mit41301/RDA5807M-arduino-nano-clone-FM-radio/mega328_FM/mega328_FM-B.Cu-single.pdf

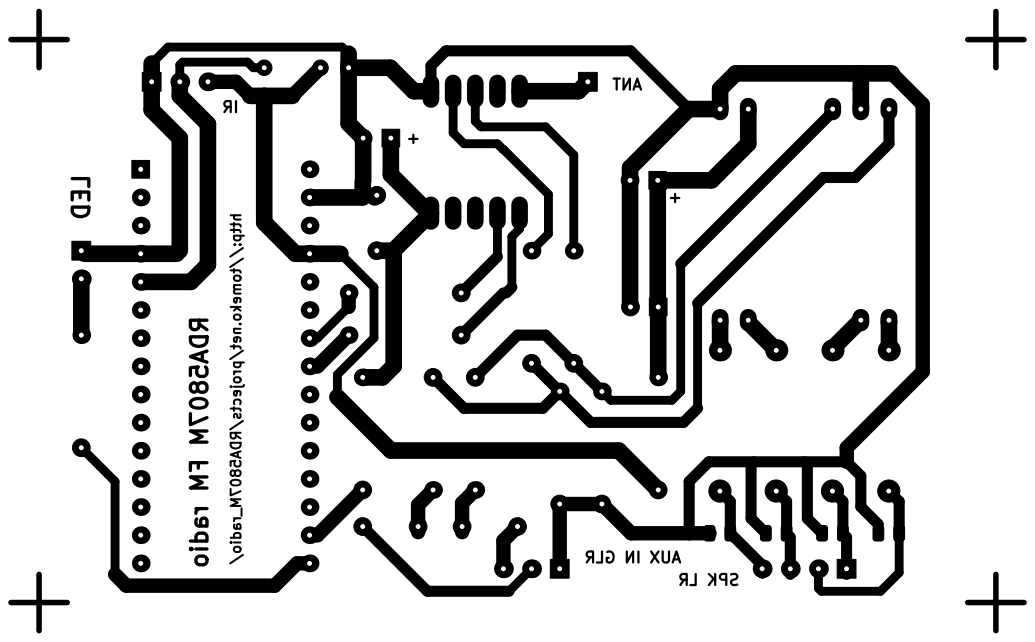
[picture p1: page 1]

AUX IN GLR LED http://tomeko.net/projects/RDA5807M_radio/ RDA5807M FM radio
