mit41301/RDA5807M-arduino-nano-clone-FM-radio/mega328_FM/mega328_FM-B.Cu.pdf

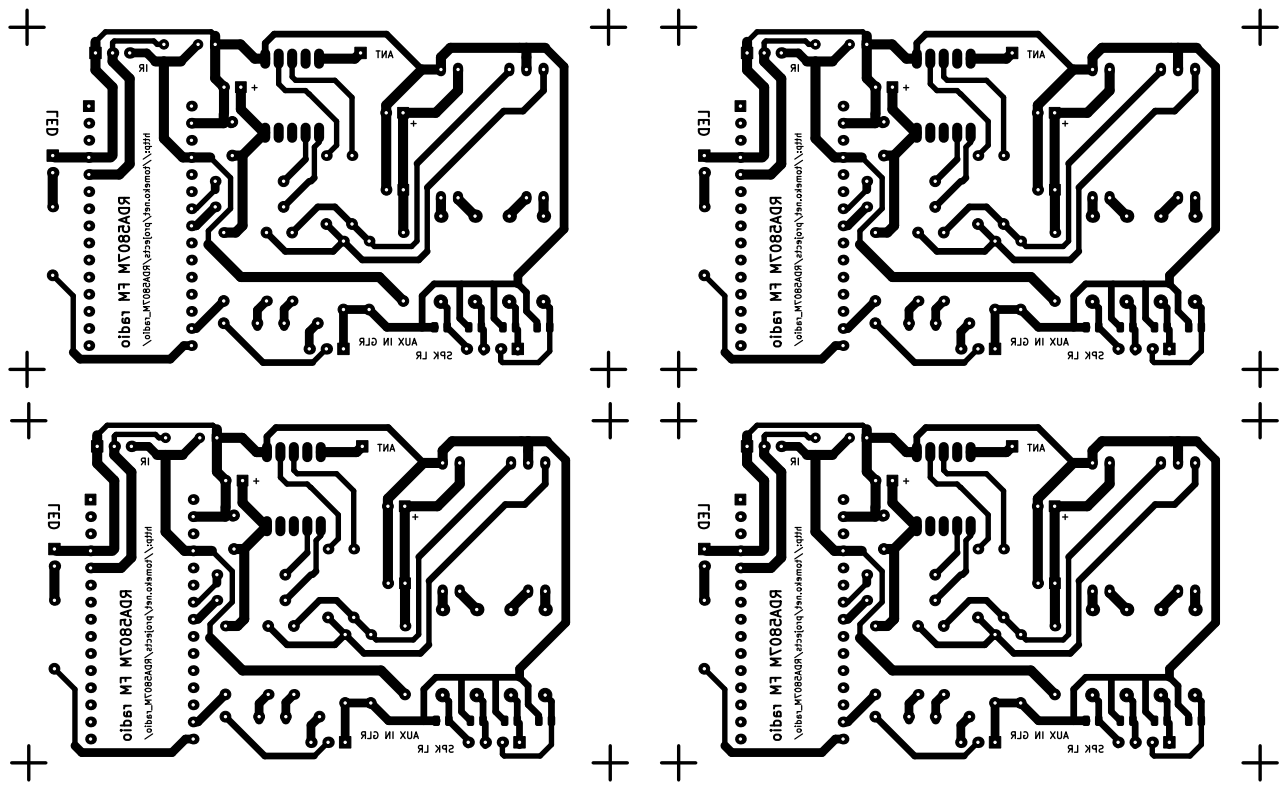
[picture p2: page 1]

AUX IN GLR LED http://tomeko.net/projects/RDA5807M_radio/ RDA5807M FM radio

SPK LR http://tomeko.net/projects/RDA5807M_radio/ RDA5807M FM radio

SPK LR + AUX IN GLR

AUX IN GLR LED RDA5807M FM radio + http://tomeko.net/projects/RDA5807M_radio/ + LED http://tomeko.net/projects/RDA5807M_radio/ ANT AUX IN GLR

IR + ANT SPK LR
