mit41301/RDA5807M-arduino-nano-clone-FM-radio/mega328_FM/mega328_FM.pdf

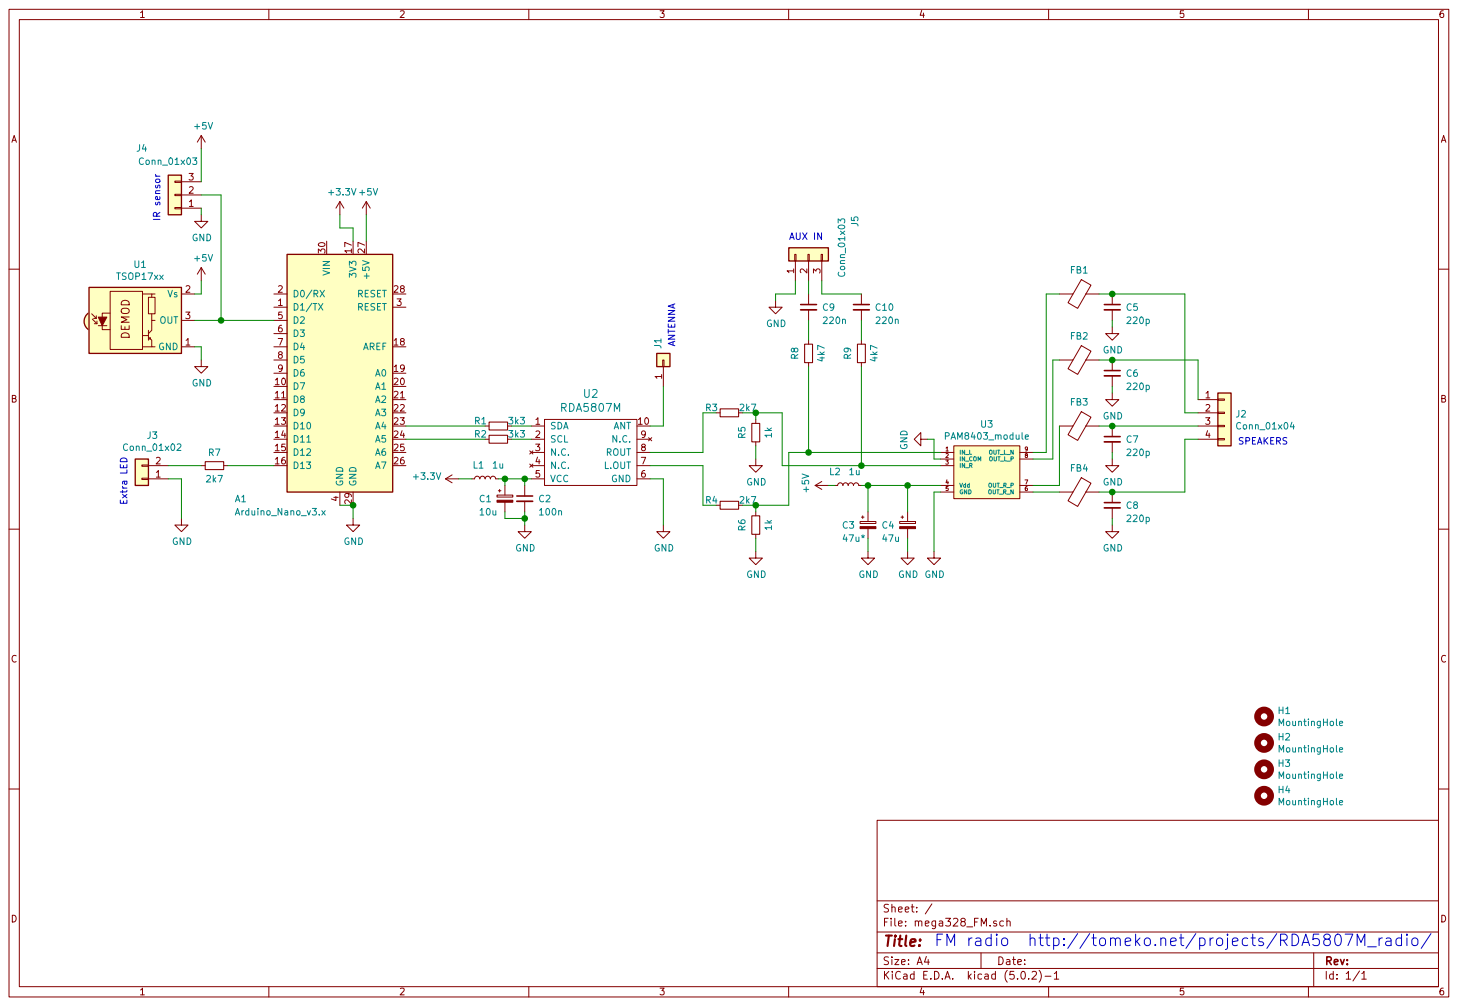
[picture p3: page 1]
