mit41301/RDA5807M-arduino-nano-clone-FM-radio/mega328_FM/mega328_FM.kicad_pcb

## KiCad design mega328_FM/mega328_FM.kicad_pcb (2025-11-18)

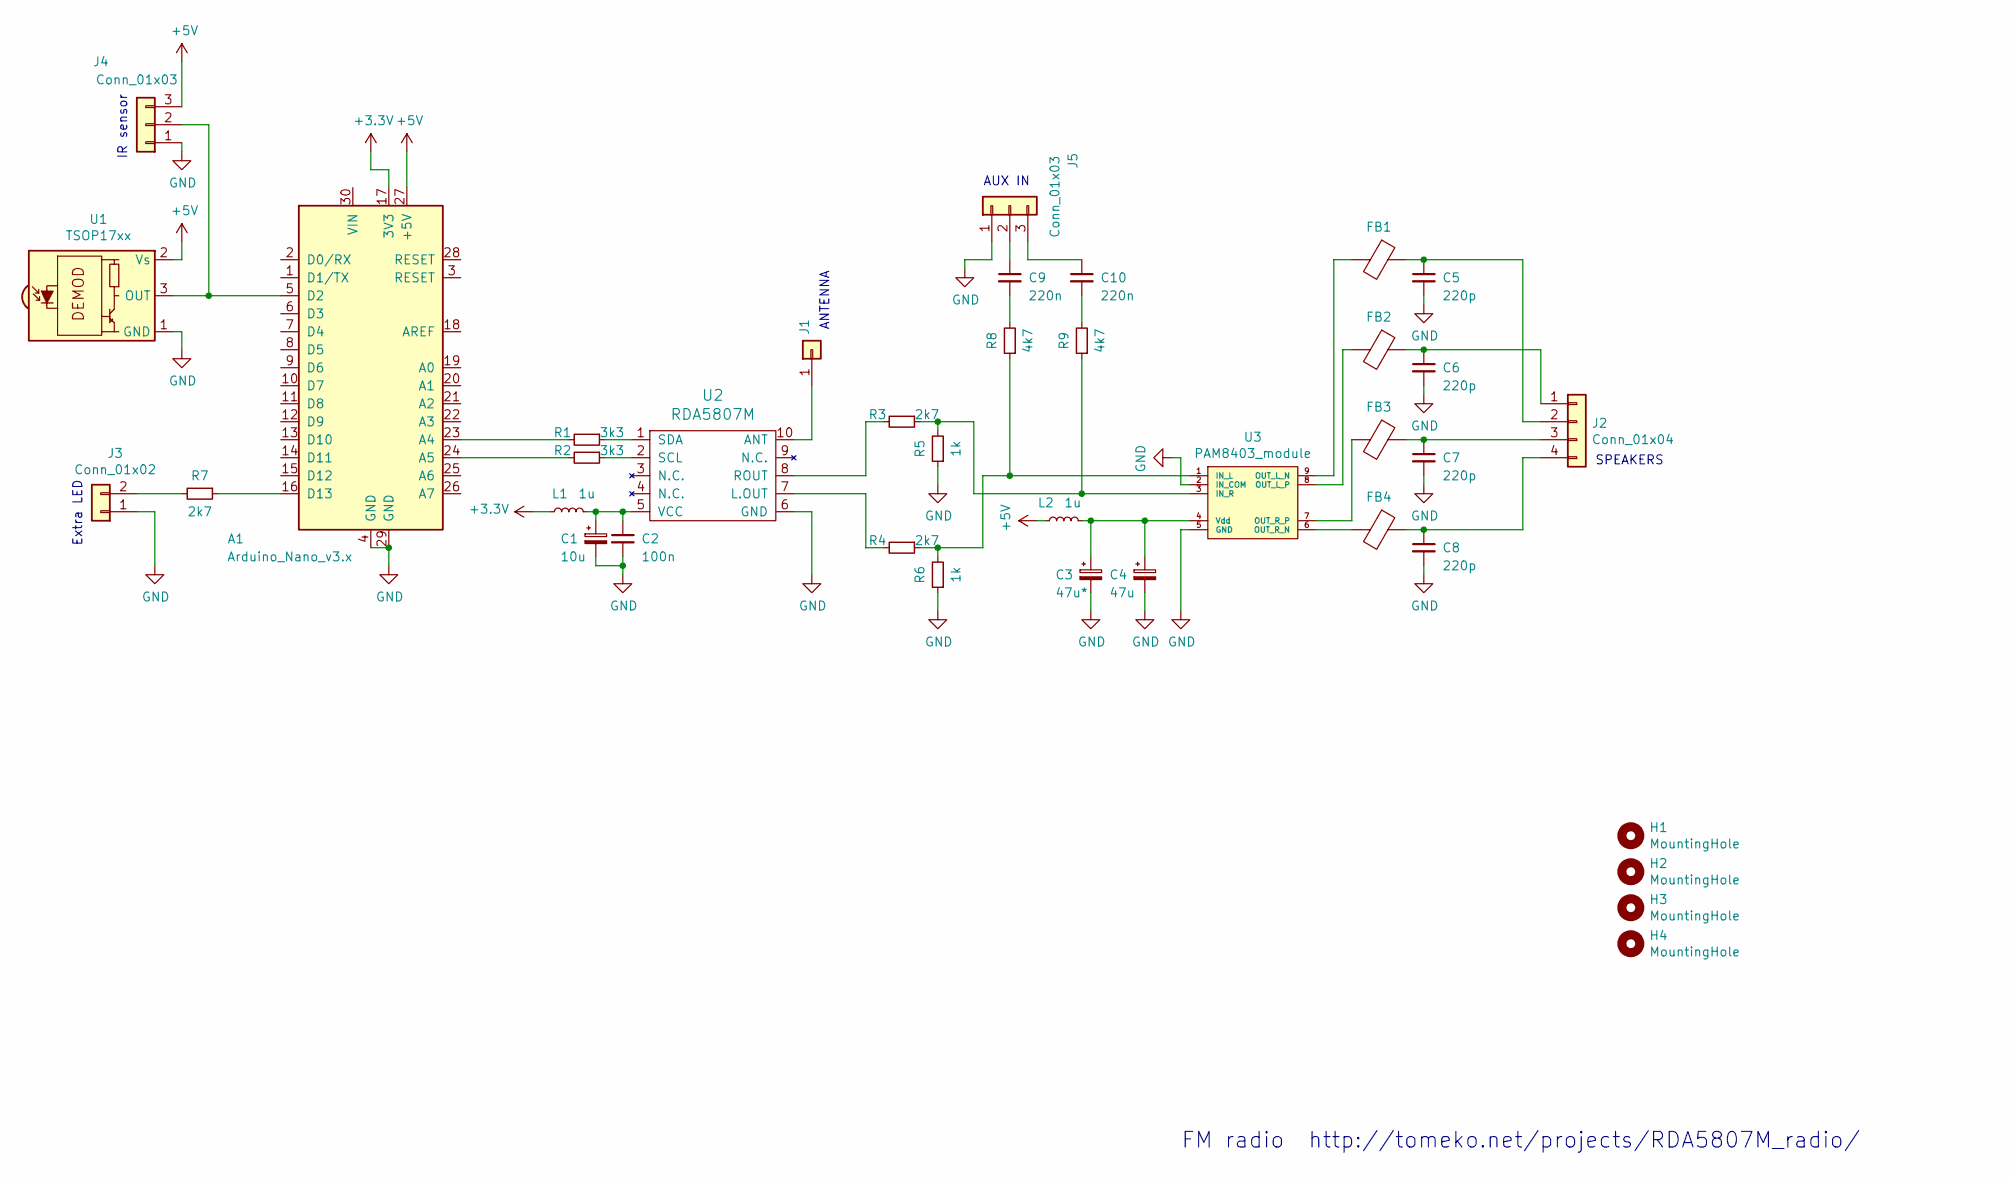
[picture p4: schematic mega328_FM.sch]

Parts:
A1: Arduino_Nano_v3.x; Arduino_Nano
C1: 10u; CP_Radial_D5.0mm_P2.50mm
C2: 100n; C_Disc_D5.0mm_W2.5mm_P5.00mm
C3: 47u*; CP_Radial_D7.5mm_P2.50mm
C4: 47u; CP_Radial_D7.5mm_P2.50mm
C5, C6, C7, C8: 220p; C_0805_2012Metric
C9, C10: 220n; C_Rect_L7.2mm_W3.5mm_P5.00mm_FKS2_FKP2_MKS2_MKP2
FB1, FB2, FB3, FB4: Ferrite_Bead; L_Axial_L9.5mm_D4.0mm_P12.70mm_Horizontal_Fastron_SMCC
H1, H2, H3, H4: MountingHole; MountingHole_3.2mm_M3
J1: Conn_01x01 ANTENNA; PinHeader_1x01_P2.54mm_Vertical
J2: Conn_01x04; PinHeader_1x04_P2.54mm_Vertical
J3: Conn_01x02; PinHeader_1x02_P2.54mm_Vertical
J4, J5: Conn_01x03; PinHeader_1x03_P2.54mm_Vertical
L1, L2: 1u; L_Axial_L7.0mm_D3.3mm_P10.16mm_Horizontal_Fastron_MICC
R1, R2: 3k3; R_Axial_DIN0207_L6.3mm_D2.5mm_P10.16mm_Horizontal
R3, R4, R7: 2k7; R_Axial_DIN0207_L6.3mm_D2.5mm_P10.16mm_Horizontal
R5, R6: 1k; R_Axial_DIN0207_L6.3mm_D2.5mm_P10.16mm_Horizontal
R8, R9: 4k7; R_Axial_DIN0207_L6.3mm_D2.5mm_P10.16mm_Horizontal
U1: TSOP17xx; Vishay_CAST-3Pin
U2: RDA5807M; RDA5807M_SMD
U3: PAM8403_module

Connections:
+3V3: A1.17 (3V3), L1.1
+5V: A1.27 (+5V), J4.3, L2.1, U1.2 (Vs)
GND: A1.4 (GND), A1.29 (GND), C1.2, C2.2, C3.2, C4.2, C5.2, C6.2, C7.2, C8.2, J3.1, J4.1, J5.1, R5.1, R6.1, U1.1 (GND), U2.6 (GND), U3.2 (IN_COM), U3.5 (GND)
unnamed: A1.5 (D2), J4.2, U1.3 (OUT)
unnamed: A1.16 (D13), R7.1
unnamed: A1.23 (A4), R1.2
unnamed: A1.24 (A5), R2.2
unnamed: C1.1, C2.1, L1.2, U2.5 (VCC)
unnamed: C3.1, C4.1, L2.2, U3.4 (Vdd)
unnamed: C5.1, FB1.1, J2.2
unnamed: C6.1, FB2.1, J2.1
unnamed: C7.1, FB3.1, J2.3
unnamed: C8.1, FB4.1, J2.4
unnamed: C9.1, J5.2
unnamed: C9.2, R8.2
unnamed: C10.1, J5.3
unnamed: C10.2, R9.2
unnamed: FB1.2, U3.9 (OUT_L_N)
unnamed: FB2.2, U3.8 (OUT_L_P)
unnamed: FB3.2, U3.7 (OUT_R_P)
unnamed: FB4.2, U3.6 (OUT_R_N)
unnamed: J1.1, U2.10 (ANT)
unnamed: J3.2, R7.2
unnamed: R1.1, U2.1 (SDA)
unnamed: R2.1, U2.2 (SCL)
unnamed: R3.1, R5.2, R9.1, U3.3 (IN_R)
unnamed: R3.2, U2.8 (ROUT)
unnamed: R4.1, R6.2, R8.1, U3.1 (IN_L)
unnamed: R4.2, U2.7 (L.OUT)

Notes on the sheet:
Extra LED
ANTENNA
SPEAKERS
IR sensor
AUX IN
FM radio http://tomeko.net/projects/RDA5807M_radio/

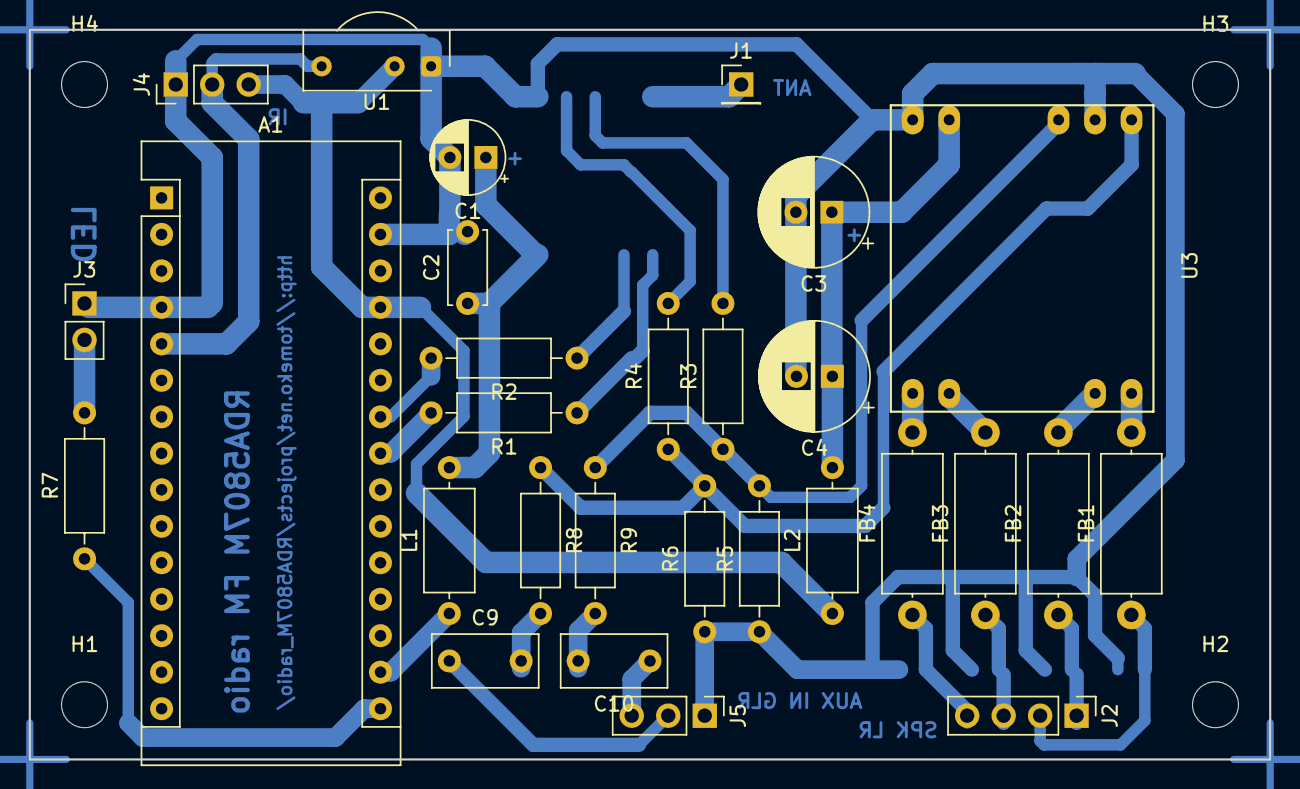
[picture p5: board mega328_FM.kicad_pcb from above]

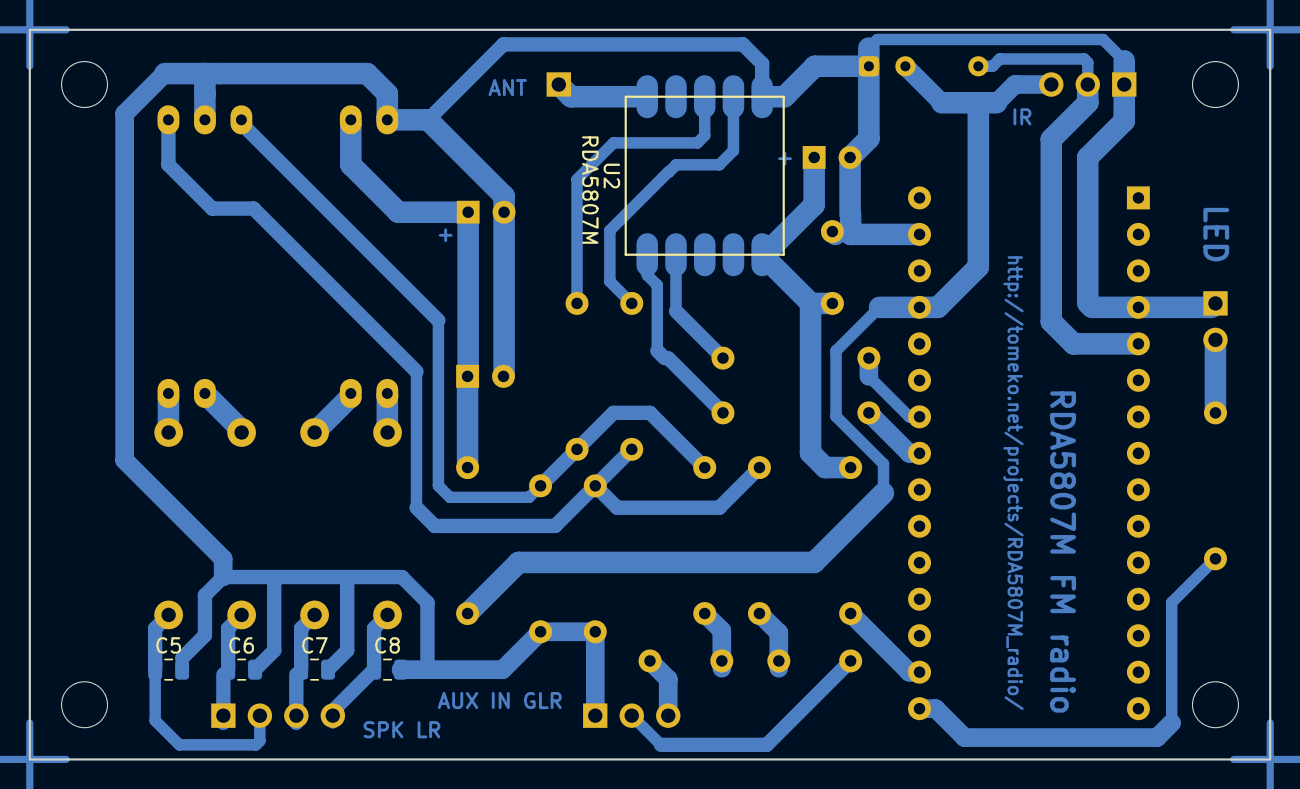
[picture p6: board mega328_FM.kicad_pcb from below]

Board: 2 copper layers, 86.4 x 50.8 mm, 38 parts (5 on the bottom side), 29 nets.
