mit41301/RDA5807M-arduino-nano-clone-FM-radio/(notices)

Notices in the files:
mega328_FM_20190223/libnecdecoder.c:
(c) 2013 by Malte Pöggel - All rights reserved. - License: BSD
